TMR177/WAPOW/(commit log)

2026-07-23 WAPOW v0: the dash, the boards, the docs — free forever
    Open-source adaptive racing display. Pi 5 + 7in touch runs the pygame
    dash (full scripted sim fallback — runs on any PC with zero hardware);
    Teensy 4.1 handles fast acquisition over CAN; IMU drives context
    detection; OBD supplies engine data. Spec, wiring/board sheets, sensor
    reference, and materials list included. GPL-3.0.
2026-07-23 Sponsor button: GitHub Sponsors + Ko-fi
